kotobuki/MeganeMouse/(commit log)

2025-11-18 Add external switch support for left mouse button
    Implements GPIO pin 1 as an external switch input to provide left mouse button functionality, complementing the head-tracking cursor movement. This allows users to separate clicking from movement controls for better accessibility.
    Changes:
    - Add SWITCH_PIN configuration (GPIO 1) with INPUT_PULLUP
    - Implement button state tracking (switchIsPressed/switchWasPressed)
    - Add USB HID button handling via Mouse.press()/release()
    - Add Bluetooth HID button support in HID report byte
    - Create status bar display showing connection mode and switch state
    - Update CLAUDE.md with external switch documentation
    The status bar displays at screen bottom (e.g.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
2025-12-20 Add dual-switch support and on-device sensitivity control
    Implements comprehensive mouse button support and quick sensitivity adjustment to enhance usability and independence from web configuration.
    Major Features:
    - Dual external switches for left (GPIO 1) and right (GPIO 2) mouse buttons
    - USB HID: Mouse.press()/release() for both buttons
    - Bluetooth HID: Bit-encoded button states (bit 0=left, bit 1=right)
    - State tracking with edge detection for reliable press/release
    - Double-click device button to cycle sensitivity (LOW → MED → HI)
    - Auto-saves to flash memory
    - Provides quick adjustment without web interface
    - Enhanced status bar display showing three sections:
    - Conne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
2025-12-21 Add wiring diagram and clarify switch requirements
    Updates both README files to include a reference to the external switch wiring diagram and clarifies that momentary switches are required.
    - Add MeganeMouse_Wiring.png reference to Hardware Requirements section
    - Clarify switch description: "closes the circuit only while pressed"
    - Emphasizes need for momentary switches (not toggle switches)
    - Consistent updates across README.md (Japanese) and README_en.md (English)
    This helps users understand the correct hardware needed and provides visual guidance for connecting external switches to GPIO 1 and 2.
    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
2026-01-16 Skip calibration countdown when movement detected during stillness check
    Previously, when movement was constantly detected during the stillness detection phase, the code would timeout and proceed to run the full calibration phase with countdown anyway. This was confusing as the countdown appeared even though the device was clearly moving.
    Now when stillness detection times out, the calibration phase is skipped entirely and fallback calibration values are used instead, with appropriate display feedback for each scenario.
    [MeganeMouse.ino]
2026-02-27 Make external switch input mode configurable (INPUT_PULLUP or INPUT)
    - Add a web interface option to choose between INPUT_PULLUP (active LOW, default) and INPUT (active HIGH) for the external switch pins. This allows active-high sensors to be used without requiring a hardware pull-down resistor.
    = When INPUT mode is selected, the right mouse button (GPIO 2) is disabled to prevent random clicks when only one sensor is connected.
    - The setting is persisted in flash memory via the Preferences library.
    - Update README_en.md, README.md, and CLAUDE.md to document the new configuration option and wiring requirements.
    [MeganeMouse.ino]
2026-04-05 Add SoundSampleCollector to collect samples
2026-04-06 Refactor: Move audio label management entirely to the PC receiver
    This commit simplifies the SoundSampleCollector firmware and updates the Python receiver to handle data labeling flexibly on the host side.
    Firmware (SoundSampleCollector.ino):
    - Removed hardcoded class names and internal label state.
    - Removed button double-click logic for switching classes.
    - Removed the "CLASS" serial command handling.
    - Simplified the AtomS3R display UI to only show the total record count.
    - Fixed a Core 1 panic (LoadProhibited) caused by a leftover `%s` format specifier.
    PC Receiver (receive_samples.py):
    - Added `--label` as a required argument when entering the receiving loop.
    - Removed the `--command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
    [SoundSampleCollector.ino, receive_samples.py]
2026-04-06 feat: Add SoundInferenceTester for continuous inference verification
    - Add a new sketch to verify the trained Edge Impulse model before final integration into MeganeMouse.
    - Implement FreeRTOS dual-core architecture: Core 0 handles audio capture and ML inference, while Core 1 is reserved for the main loop (BLE/Mouse control).
    - Use FreeRTOS task notifications (`ulTaskNotifyTake` / `xTaskNotifyGive`) to safely synchronize audio recording and inference tasks, preventing WDT crashes on Core 0.
    - Include detailed serial monitor output for real-time evaluation of class probabilities and DSP/classification timing.
    - Add documentation comments instructing how to safely reduce detection latency by m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
    [SoundInferenceTester.ino]
2026-04-09 Fix comment typo and improve debouncing with consecutive frame detection
    - Fix typo: "Microphonne" -> "Microphone"
    - Translate remaining Japanese comments to English
    - Introduce consecutive frame detection (smoothing) before time-based debounce
    - Replace > with >= in debounce time comparison
    [SoundInferenceTester.ino]
2026-04-09 Update SoundInferenceTester READMEs to document robust click detection
    Add a feature bullet describing the consecutive frame confirmation and
    time-based debounce introduced in the previous commit.
2026-04-10 Add Edge Impulse training and tuning guide in Japanese and English
    Documents lessons learned while building the sound-based click model,
    covering class design, data collection, DSP configuration, classifier
    architecture, and on-device deployment tips.
